The90Frank/cat-feeder/cad/export/auger.step

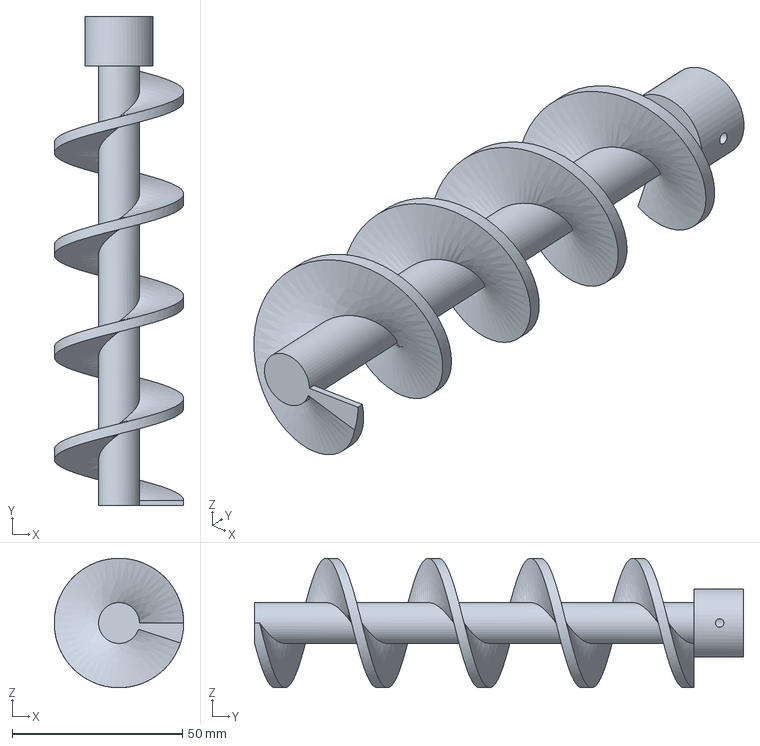
[picture p1: CAD file, 2026-10-20]
cad/export/auger.step
38.0 x 143.5 x 38.0 mm
