The90Frank/cat-feeder/cad/export/desiccant-cover.step

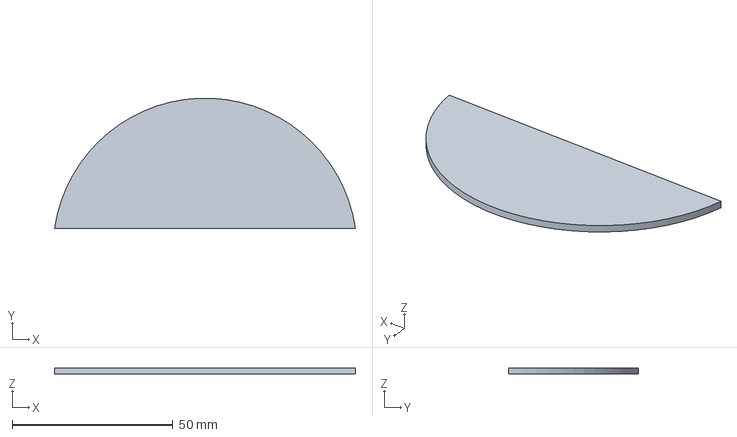
[picture p2: CAD file, 2026-10-20]
cad/export/desiccant-cover.step
93.6 x 40.5 x 2.00 mm
