The90Frank/cat-feeder/cad/export/bay-door.step

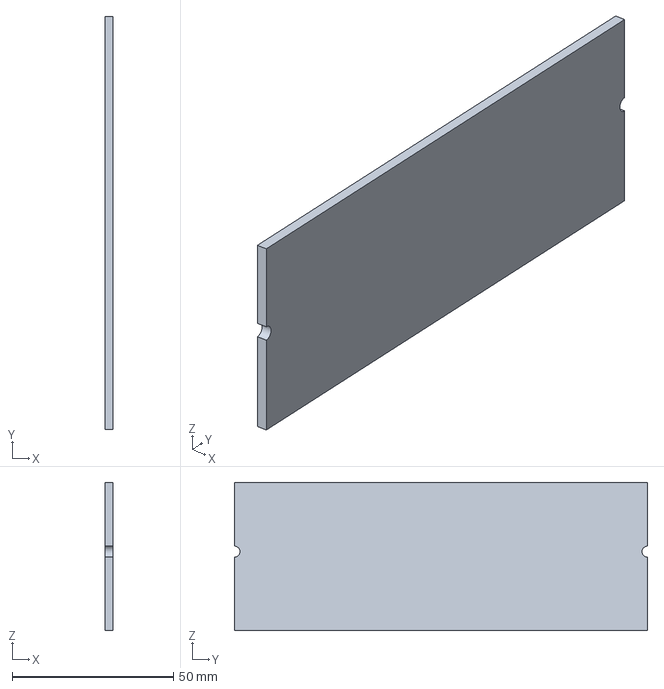
[picture p3: CAD file, 2026-10-20]
cad/export/bay-door.step
2.50 x 128.0 x 46.0 mm
