The90Frank/cat-feeder/cad/export/lid.step

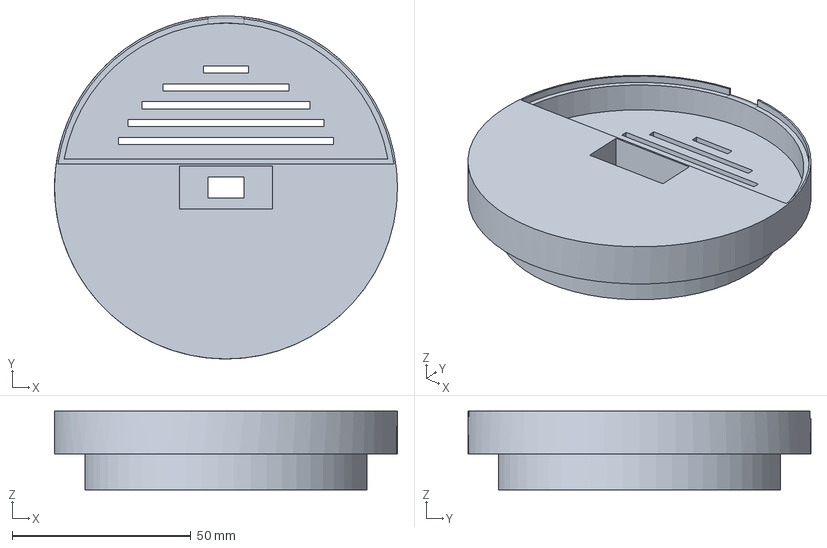
[picture p4: CAD file, 2026-10-20]
cad/export/lid.step
96.0 x 96.0 x 22.0 mm
