The90Frank/cat-feeder/cad/export/upper-bracket.step

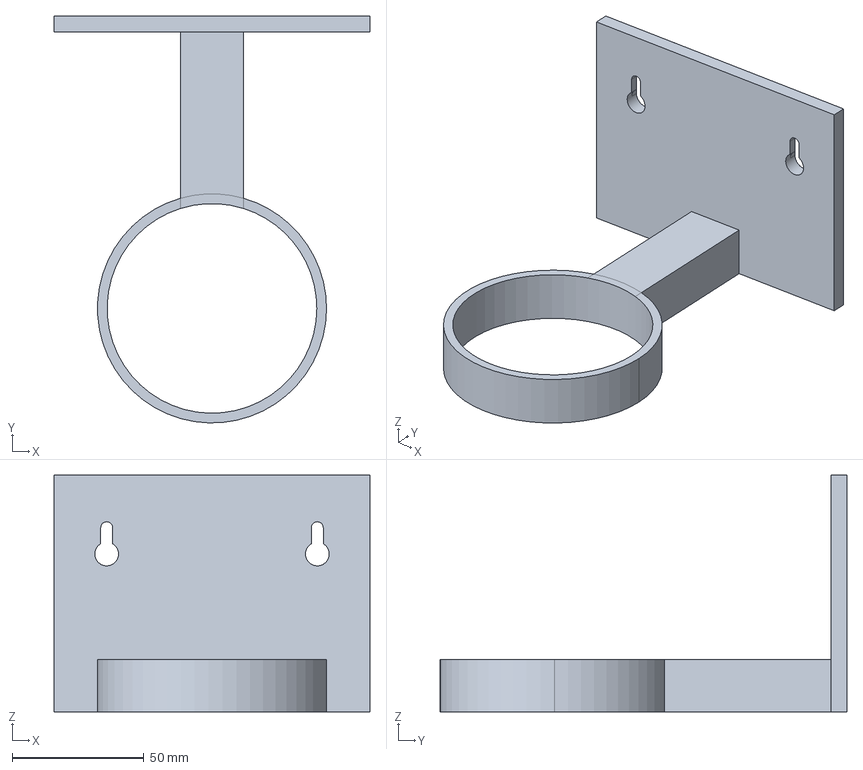
[picture p5: CAD file, 2026-10-20]
cad/export/upper-bracket.step
120.0 x 154.5 x 90.0 mm
