The90Frank/cat-feeder/cad/export/rear-base.step

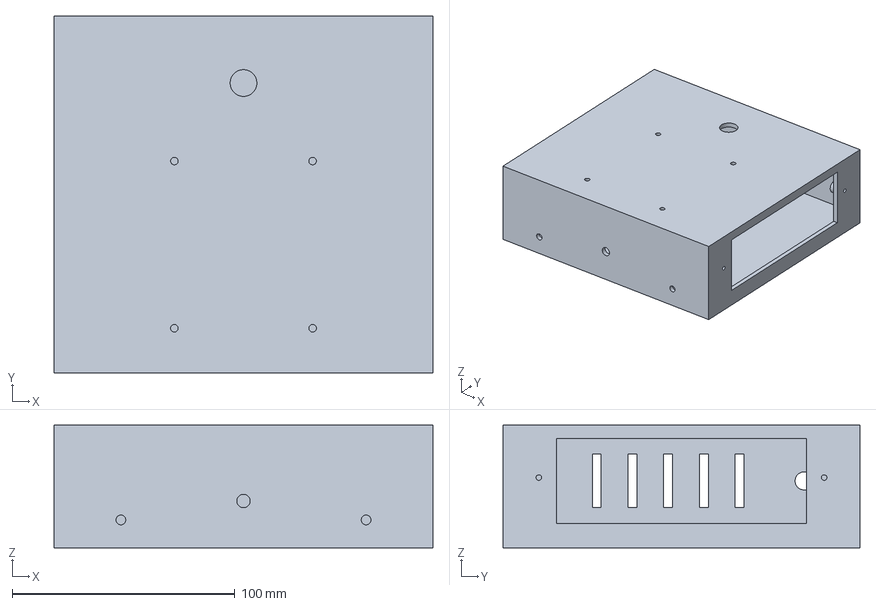
[picture p6: CAD file, 2026-10-20]
cad/export/rear-base.step
170.0 x 160.0 x 55.0 mm
