The90Frank/cat-feeder/cad/export/auger-housing.step

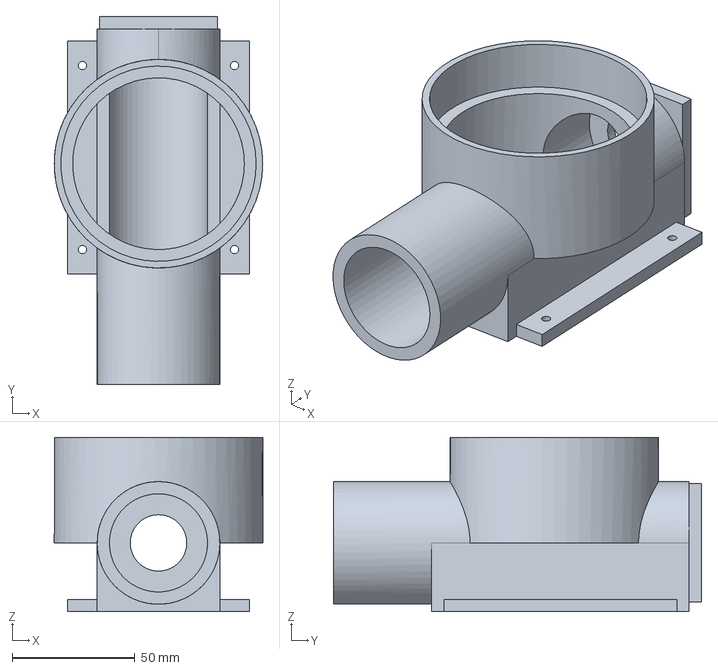
[picture p7: CAD file, 2026-10-20]
cad/export/auger-housing.step
85.0 x 150.0 x 71.0 mm
