The90Frank/cat-feeder/cad/export/bowl.step

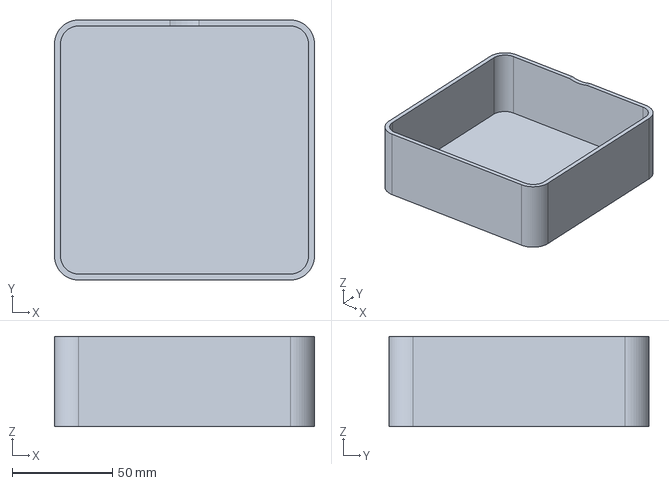
[picture p8: CAD file, 2026-10-20]
cad/export/bowl.step
130.0 x 130.0 x 45.0 mm
