The90Frank/cat-feeder/cad/export/back-plate.step

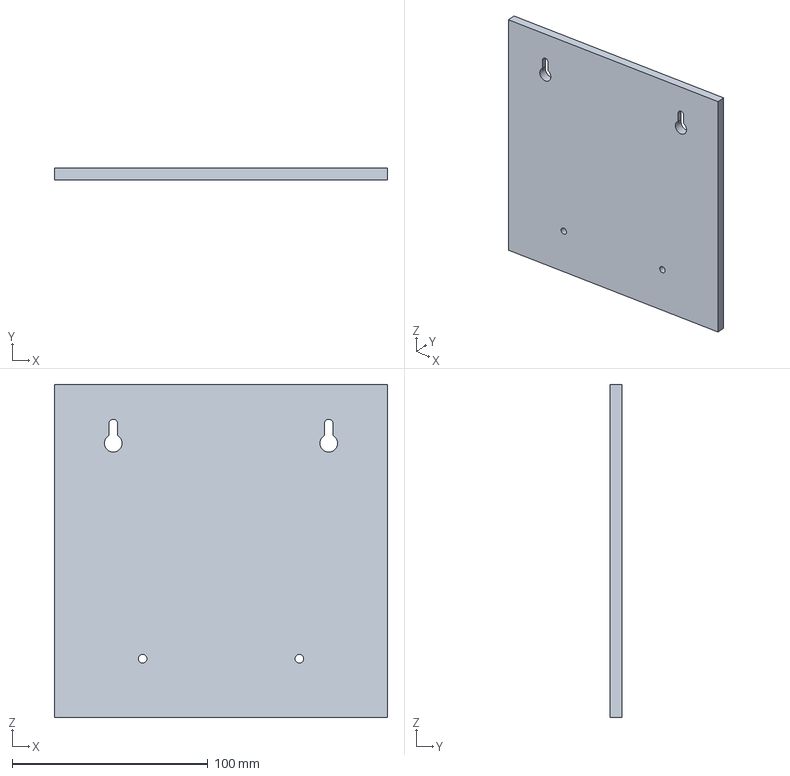
[picture p9: CAD file, 2026-10-20]
cad/export/back-plate.step
170.0 x 6.00 x 170.0 mm
