The90Frank/cat-feeder/cad/export/front-base.step

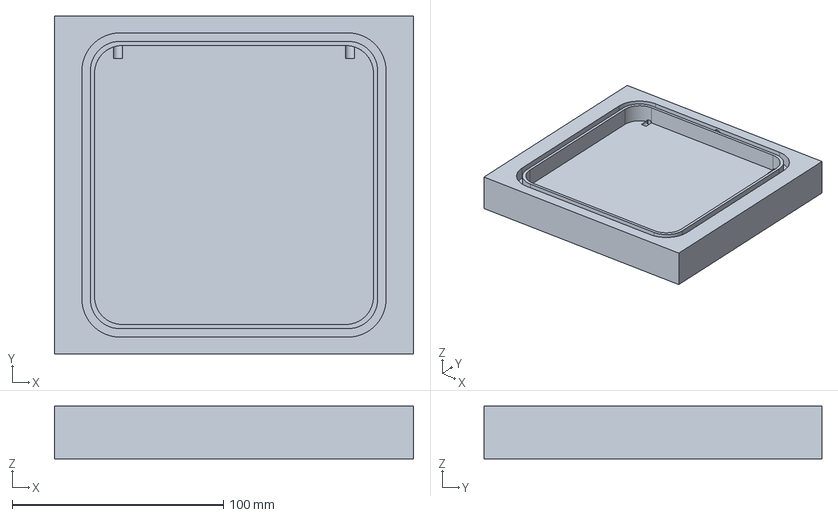
[picture p10: CAD file, 2026-10-20]
cad/export/front-base.step
170.0 x 160.0 x 25.0 mm
