The90Frank/cat-feeder/cad/export/hopper-segment.step

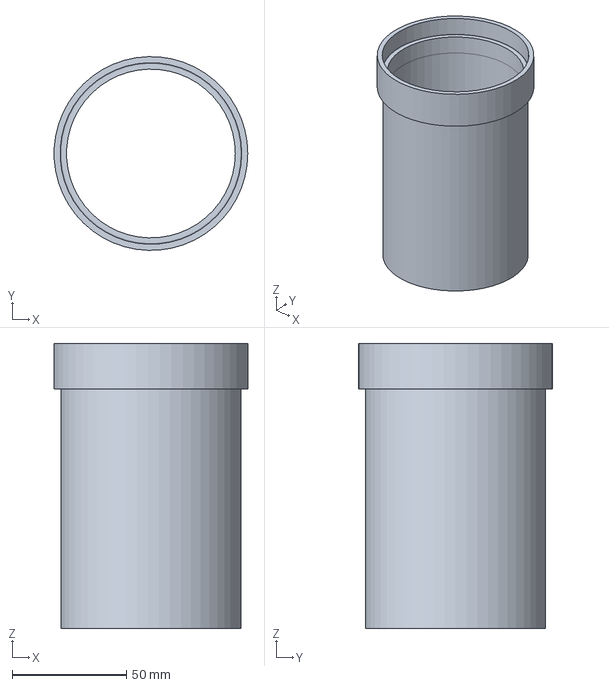
[picture p11: CAD file, 2026-10-20]
cad/export/hopper-segment.step
84.9 x 85.0 x 125.0 mm
