The90Frank/cat-feeder/(list of files, cad)

Other CAD files:
cad/export/hopper-segment1.step
cad/export/auger-housing.stl
cad/export/auger.stl
cad/export/back-plate.stl
cad/export/bay-door.stl
cad/export/bowl.stl
cad/export/desiccant-cover.stl
cad/export/front-base.stl
cad/export/hopper-segment.stl
cad/export/lid.stl
cad/export/rear-base.stl
cad/export/upper-bracket.stl
