The90Frank/cat-feeder/(commit log)

2026-10-20 Move feeding logic to the device
2026-10-20 Pick microchip reader, ToF level sensor and hopper geometry
2026-10-20 Add pin map and narrow hopper geometry
2026-10-20 Add parametric CAD model: volumes
2026-10-20 Shorten spout and cut its exit vertically
2026-10-20 Add joints, fasteners, wall keyholes and bay door to CAD model
2026-10-20 Add auger, STEP/STL exports and bill of materials
    [auger-housing.step, auger-housing.stl, auger.step, auger.stl, back-plate.step, back-plate.stl, bay-door.step, bay-door.stl]
2026-10-20 Confirm pin map against the devkit
2026-10-20 Add TMC2209 UART config and StallGuard jam detection
    [cat-feeder.yaml, tmc2209_uart.cpp, tmc2209_uart.h]
2026-10-20 Drop spout and add desiccant chamber to lid
    [auger-housing.step, auger-housing.stl, auger.step, auger.stl, back-plate.step, bay-door.step, bowl.step, bowl.stl]
2026-10-20 Make hopper segments identical and stackable
    [auger-housing.step, auger.step, back-plate.step, bay-door.step, bowl.step, desiccant-cover.step, desiccant-cover.stl, front-base.step]
2026-10-20 Update README with status, firmware and CAD usage
2026-10-20 Report missed meals at the end of each slot
    [cat-feeder.yaml]
2026-10-20 Check missed meals once per slot, at its end
    [cat-feeder.yaml]
